spark-hpi/spox/smart_plants_pcb/README.md

# PCB

This PCB has been designed and gifted to us by Alexander Kutschera. Original repo: https://github.com/vektorious/hpi_smart_plants
