spark-hpi/spox/smart_plants_pcb/smart_plants_breakout_ws-board_rev1.kicad_pcb

## KiCad design smart_plants_pcb/smart_plants_breakout_ws-board_rev1.kicad_pcb (2026-05-18)

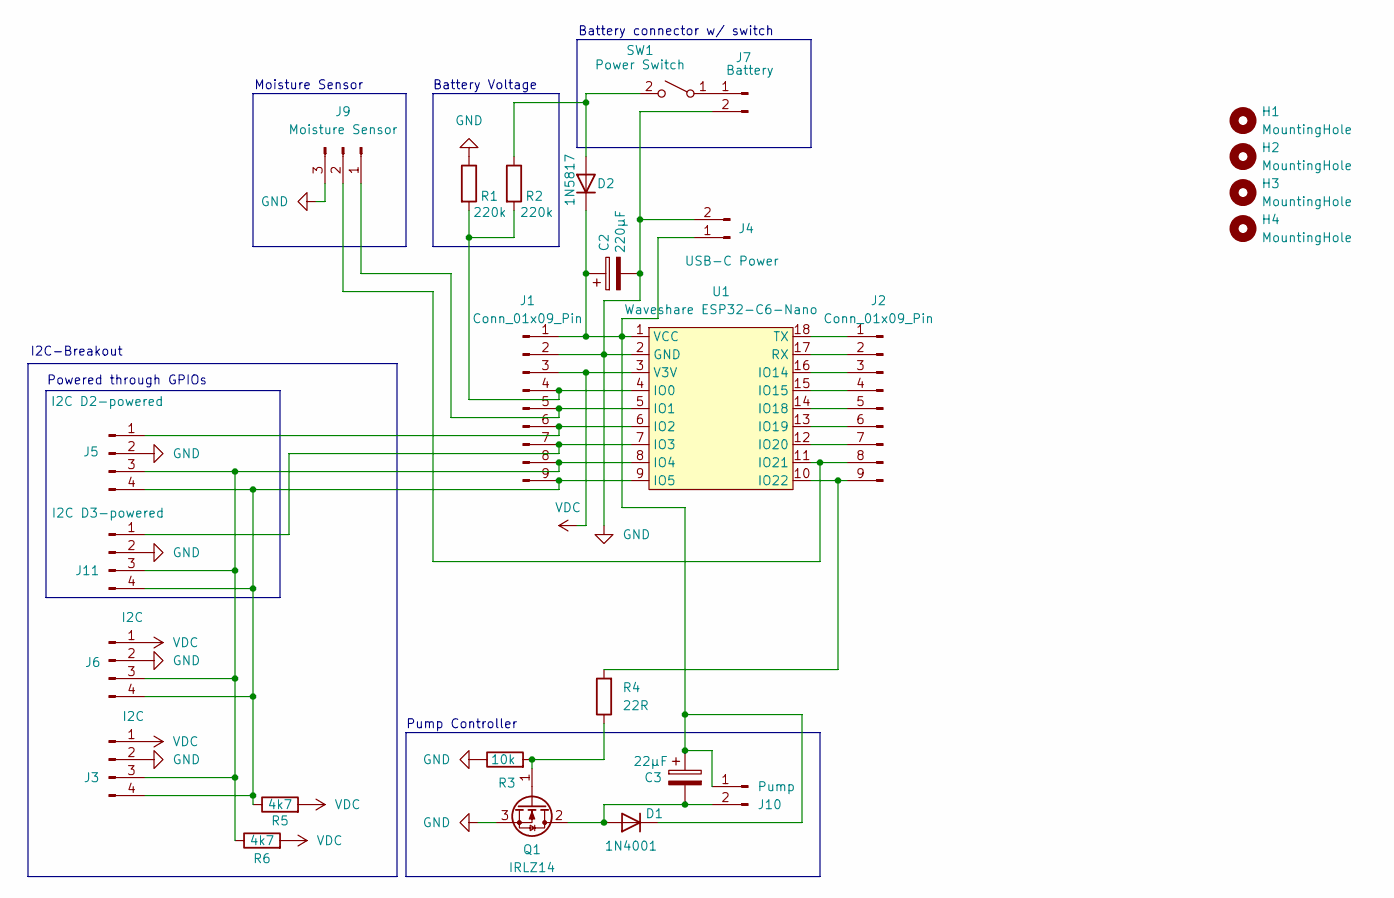
[picture p1: schematic smart_plants_breakout_ws-board_rev1.kicad_sch]

Parts:
C2: 220µF; CP_Radial_D8.0mm_P3.50mm
C3: 22µF; CP_Radial_D8.0mm_P3.50mm
D1: 1N4001; D_DO-41_SOD81_P10.16mm_Horizontal
D2: 1N5817; D_DO-41_SOD81_P10.16mm_Horizontal
H1, H2, H3, H4: MountingHole; MountingHole_2.7mm_M2.5
J1, J2: Conn_01x09_Pin; PinSocket_1x09_P2.54mm_Vertical
J3, J6: I2C; JST_XH_B4B-XH-A_1x04_P2.50mm_Vertical
J4: USB-C Power; JST_PH_B2B-PH-K_1x02_P2.00mm_Vertical
J5: I2C D2-powered; JST_XH_B4B-XH-A_1x04_P2.50mm_Vertical
J7: Battery; JST_XH_B2B-XH-A_1x02_P2.50mm_Vertical
J9: Moisture Sensor; JST_XH_B3B-XH-A_1x03_P2.50mm_Vertical
J10: Pump; JST_XH_B2B-XH-A_1x02_P2.50mm_Vertical
J11: I2C D3-powered; JST_XH_B4B-XH-A_1x04_P2.50mm_Vertical
Q1: IRLZ14; TO-220-3_Vertical
R1, R2: 220k; R_Axial_DIN0207_L6.3mm_D2.5mm_P10.16mm_Horizontal
R3: 10k; R_Axial_DIN0207_L6.3mm_D2.5mm_P10.16mm_Horizontal
R4: 22R; R_Axial_DIN0207_L6.3mm_D2.5mm_P10.16mm_Horizontal
R5, R6: 4k7; R_Axial_DIN0207_L6.3mm_D2.5mm_P10.16mm_Horizontal
SW1: Power Switch; JST_XH_B2B-XH-A_1x02_P2.50mm_Vertical
U1: Waveshare ESP32-C6-Nano; Waveshare-ESP32-C6-Zero

Connections:
GND: C2.2, J1.2, J3.2, J4.2, J5.2, J6.2, J7.2, J9.3, J11.2, Q1.3 (S), R1.1, R3.1, U1.2 (GND)
unnamed: C3.2, D1.2 (A), J10.2, Q1.2 (D)
unnamed: C2.1, C3.1, D1.1 (K), D2.1 (K), J1.1, J4.1, J10.1, U1.1 (VCC)
unnamed: D2.2 (A), R2.1, SW1.2 (B)
unnamed: J1.4, R1.2, R2.2, U1.4 (IO0)
unnamed: J1.5, J9.1, U1.5 (IO1)
unnamed: J1.6, J5.1, U1.6 (IO2)
unnamed: J1.7, J11.1, U1.7 (IO3)
unnamed: J1.8, J3.3, J5.3, J6.3, J11.3, R6.1, U1.8 (IO4)
unnamed: J1.9, J3.4, J5.4, J6.4, J11.4, R5.1, U1.9 (IO5)
unnamed: J2.1, U1.18 (TX)
unnamed: J2.2, U1.17 (RX)
unnamed: J2.3, U1.16 (IO14)
unnamed: J2.4, U1.15 (IO15)
unnamed: J2.5, U1.14 (IO18)
unnamed: J2.6, U1.13 (IO19)
unnamed: J2.7, U1.12 (IO20)
unnamed: J2.8, J9.2, U1.11 (IO21)
unnamed: J2.9, R4.2, U1.10 (IO22)
unnamed: J7.1, SW1.1 (A)
unnamed: Q1.1 (G), R3.2, R4.1
VDC: J1.3, J3.1, J6.1, R5.2, R6.2, U1.3 (V3V)

Notes on the sheet:
Battery Voltage
Battery connector w/ switch
I2C-Breakout
Pump Controller
Powered through GPIOs
Moisture Sensor

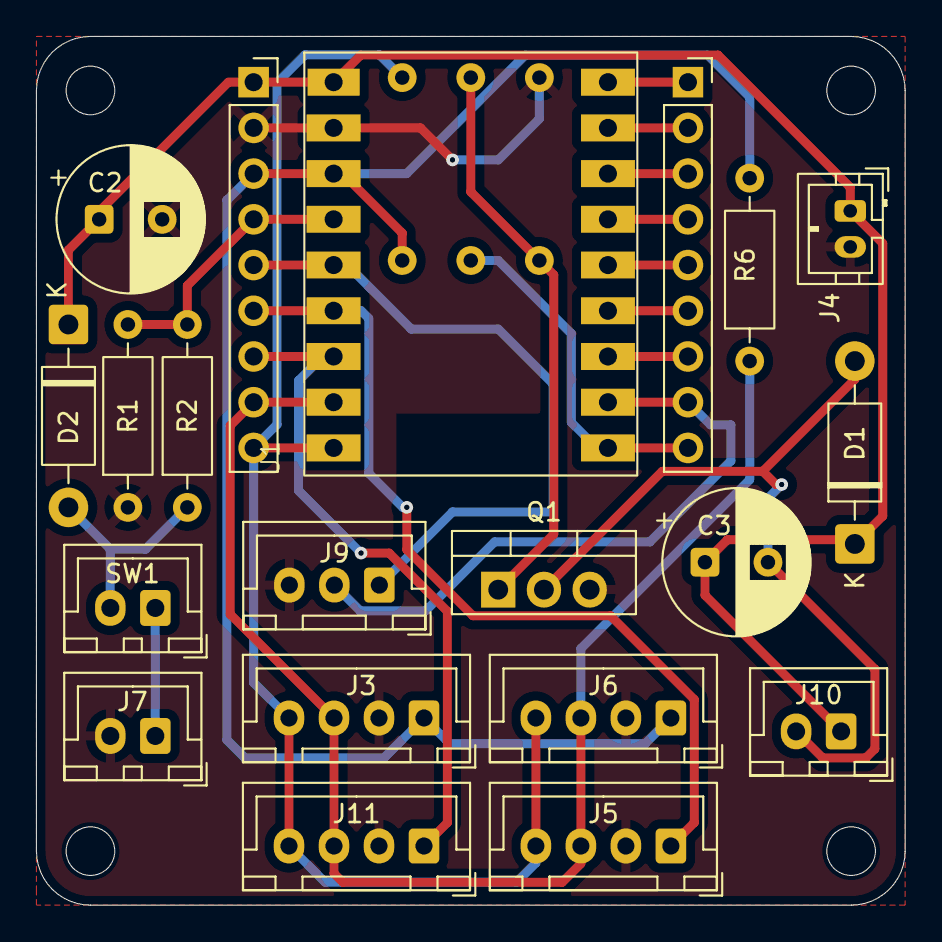
[picture p2: board smart_plants_breakout_ws-board_rev1.kicad_pcb from above]

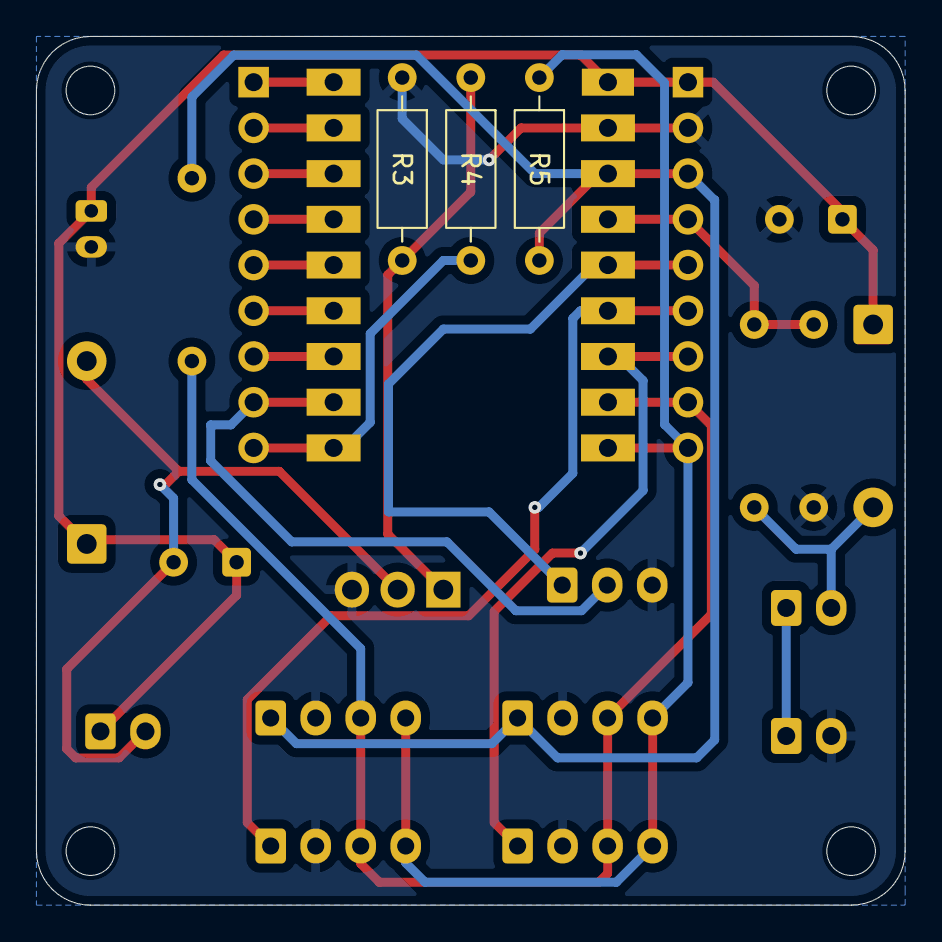
[picture p3: board smart_plants_breakout_ws-board_rev1.kicad_pcb from below]

Board: 2 copper layers, 48.3 x 48.3 mm, 27 parts (3 on the bottom side), 22 nets.
