spark-hpi/spox/(commit log)

2026-05-18 Added smart plants board files
    [smart_plants_breakout_ws-board_rev1-B_Cu.gbr, smart_plants_breakout_ws-board_rev1-B_Mask.gbr, smart_plants_breakout_ws-board_rev1-B_Paste.gbr, smart_plants_breakout_ws-board_rev1-B_Silkscreen.gbr, smart_plants_breakout_ws-board_rev1-Edge_Cuts.gbr, smart_plants_breakout_ws-board_rev1-F_Cu.gbr, smart_plants_breakout_ws-board_rev1-F_Mask.gbr, smart_plants_breakout_ws-board_rev1-F_Paste.gbr]
2026-05-18 renamed folder
    [smart_plants_breakout_ws-board_rev1-B_Cu.gbr, smart_plants_breakout_ws-board_rev1-B_Mask.gbr, smart_plants_breakout_ws-board_rev1-B_Paste.gbr, smart_plants_breakout_ws-board_rev1-B_Silkscreen.gbr, smart_plants_breakout_ws-board_rev1-Edge_Cuts.gbr, smart_plants_breakout_ws-board_rev1-F_Cu.gbr, smart_plants_breakout_ws-board_rev1-F_Mask.gbr, smart_plants_breakout_ws-board_rev1-F_Paste.gbr]
